Abdoul-razaqYussufMbalamula/dual-axis-fuzzy-solar-tracker/block-diagram.jpeg

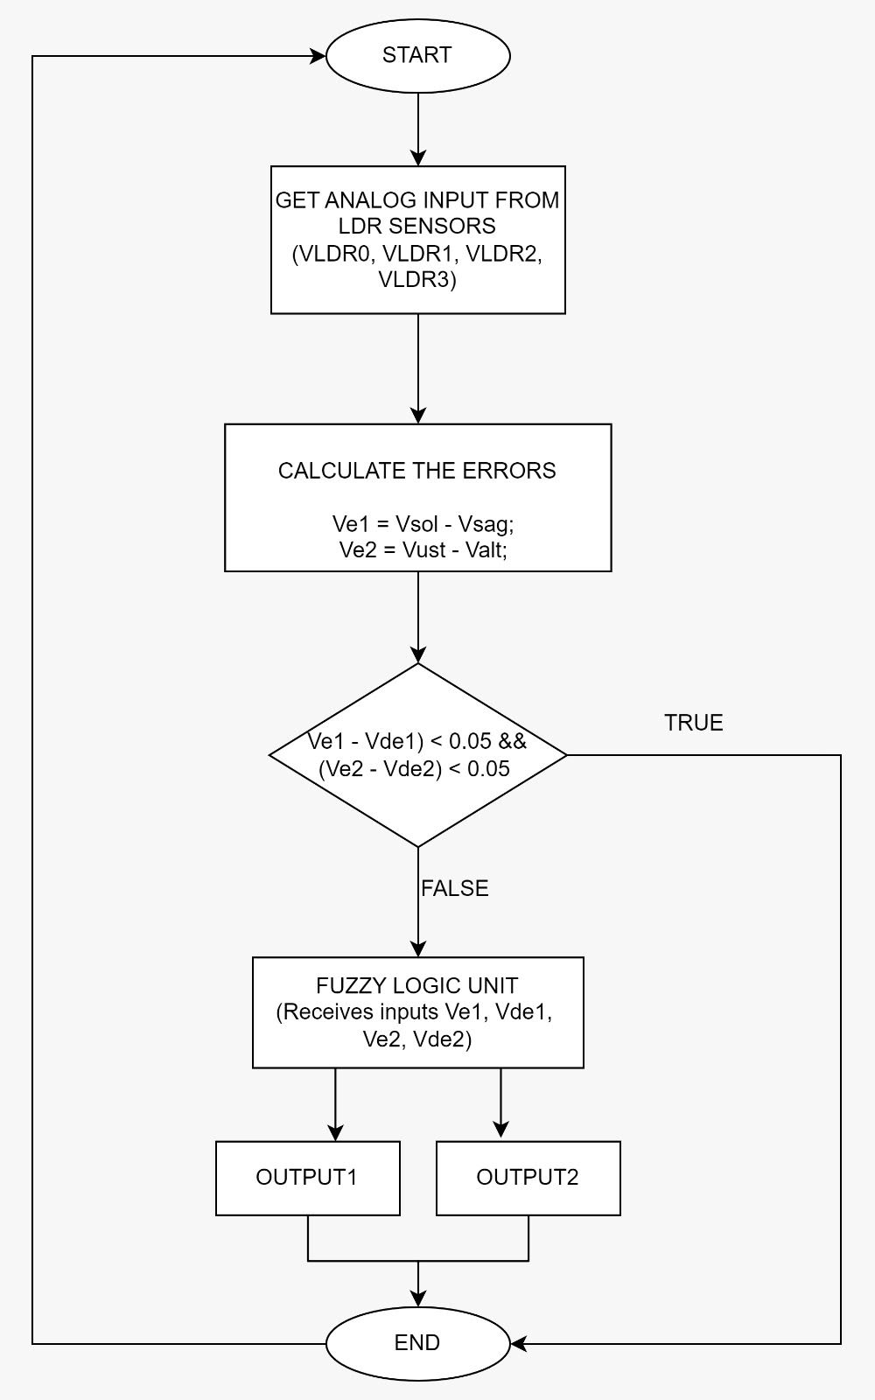
block-diagram.jpeg
