Abdoul-razaqYussufMbalamula/dual-axis-fuzzy-solar-tracker/block_diagram2.png

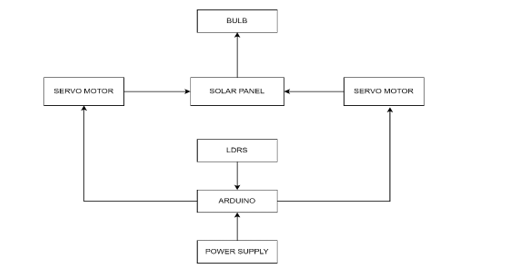
block_diagram2.png
