Abdoul-razaqYussufMbalamula/dual-axis-fuzzy-solar-tracker/fuzzylogic_graph2.png

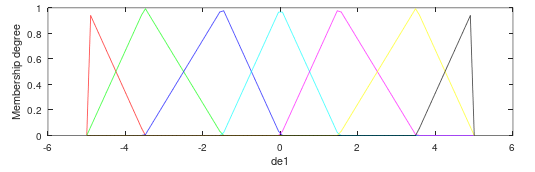
fuzzylogic_graph2.png
