Abdoul-razaqYussufMbalamula/dual-axis-fuzzy-solar-tracker/fuzzylogic_graph3.png

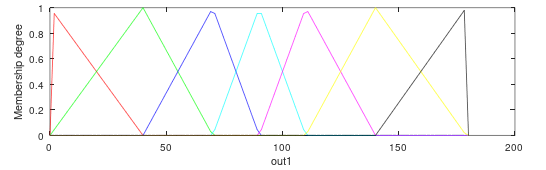
fuzzylogic_graph3.png
