Abdoul-razaqYussufMbalamula/dual-axis-fuzzy-solar-tracker/project_prototype3.jpeg

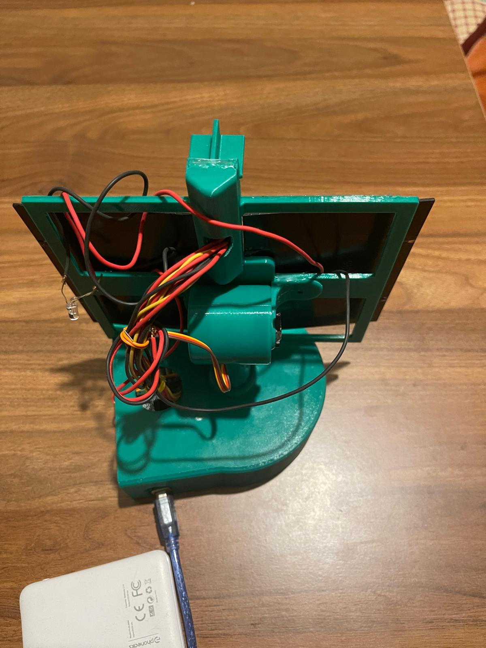
project_prototype3.jpeg
