Abdoul-razaqYussufMbalamula/dual-axis-fuzzy-solar-tracker/tinkerCad_scheme.png

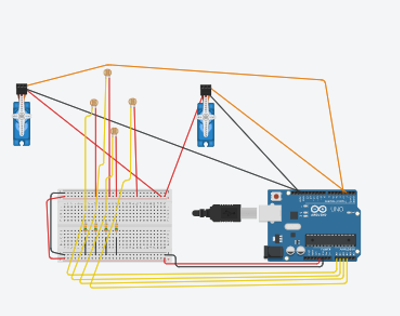
tinkerCad_scheme.png
